thomasfla/pico_dual_PMSM_BUG79100G_DRV8316C/README.md

# pico_dual_PMSM_BUG79100G_DRV8316C
Low cost PMSM using RPI Pico, external ADC and integrated mos+driver+current sensing.
