thomasfla/pico_dual_PMSM_BUG79100G_DRV8316C/hardware/pico_dual_PMSM_BUG79100G_DRV8316C.kicad_pcb

## KiCad design hardware/pico_dual_PMSM_BUG79100G_DRV8316C.kicad_pcb (2026-09-10)

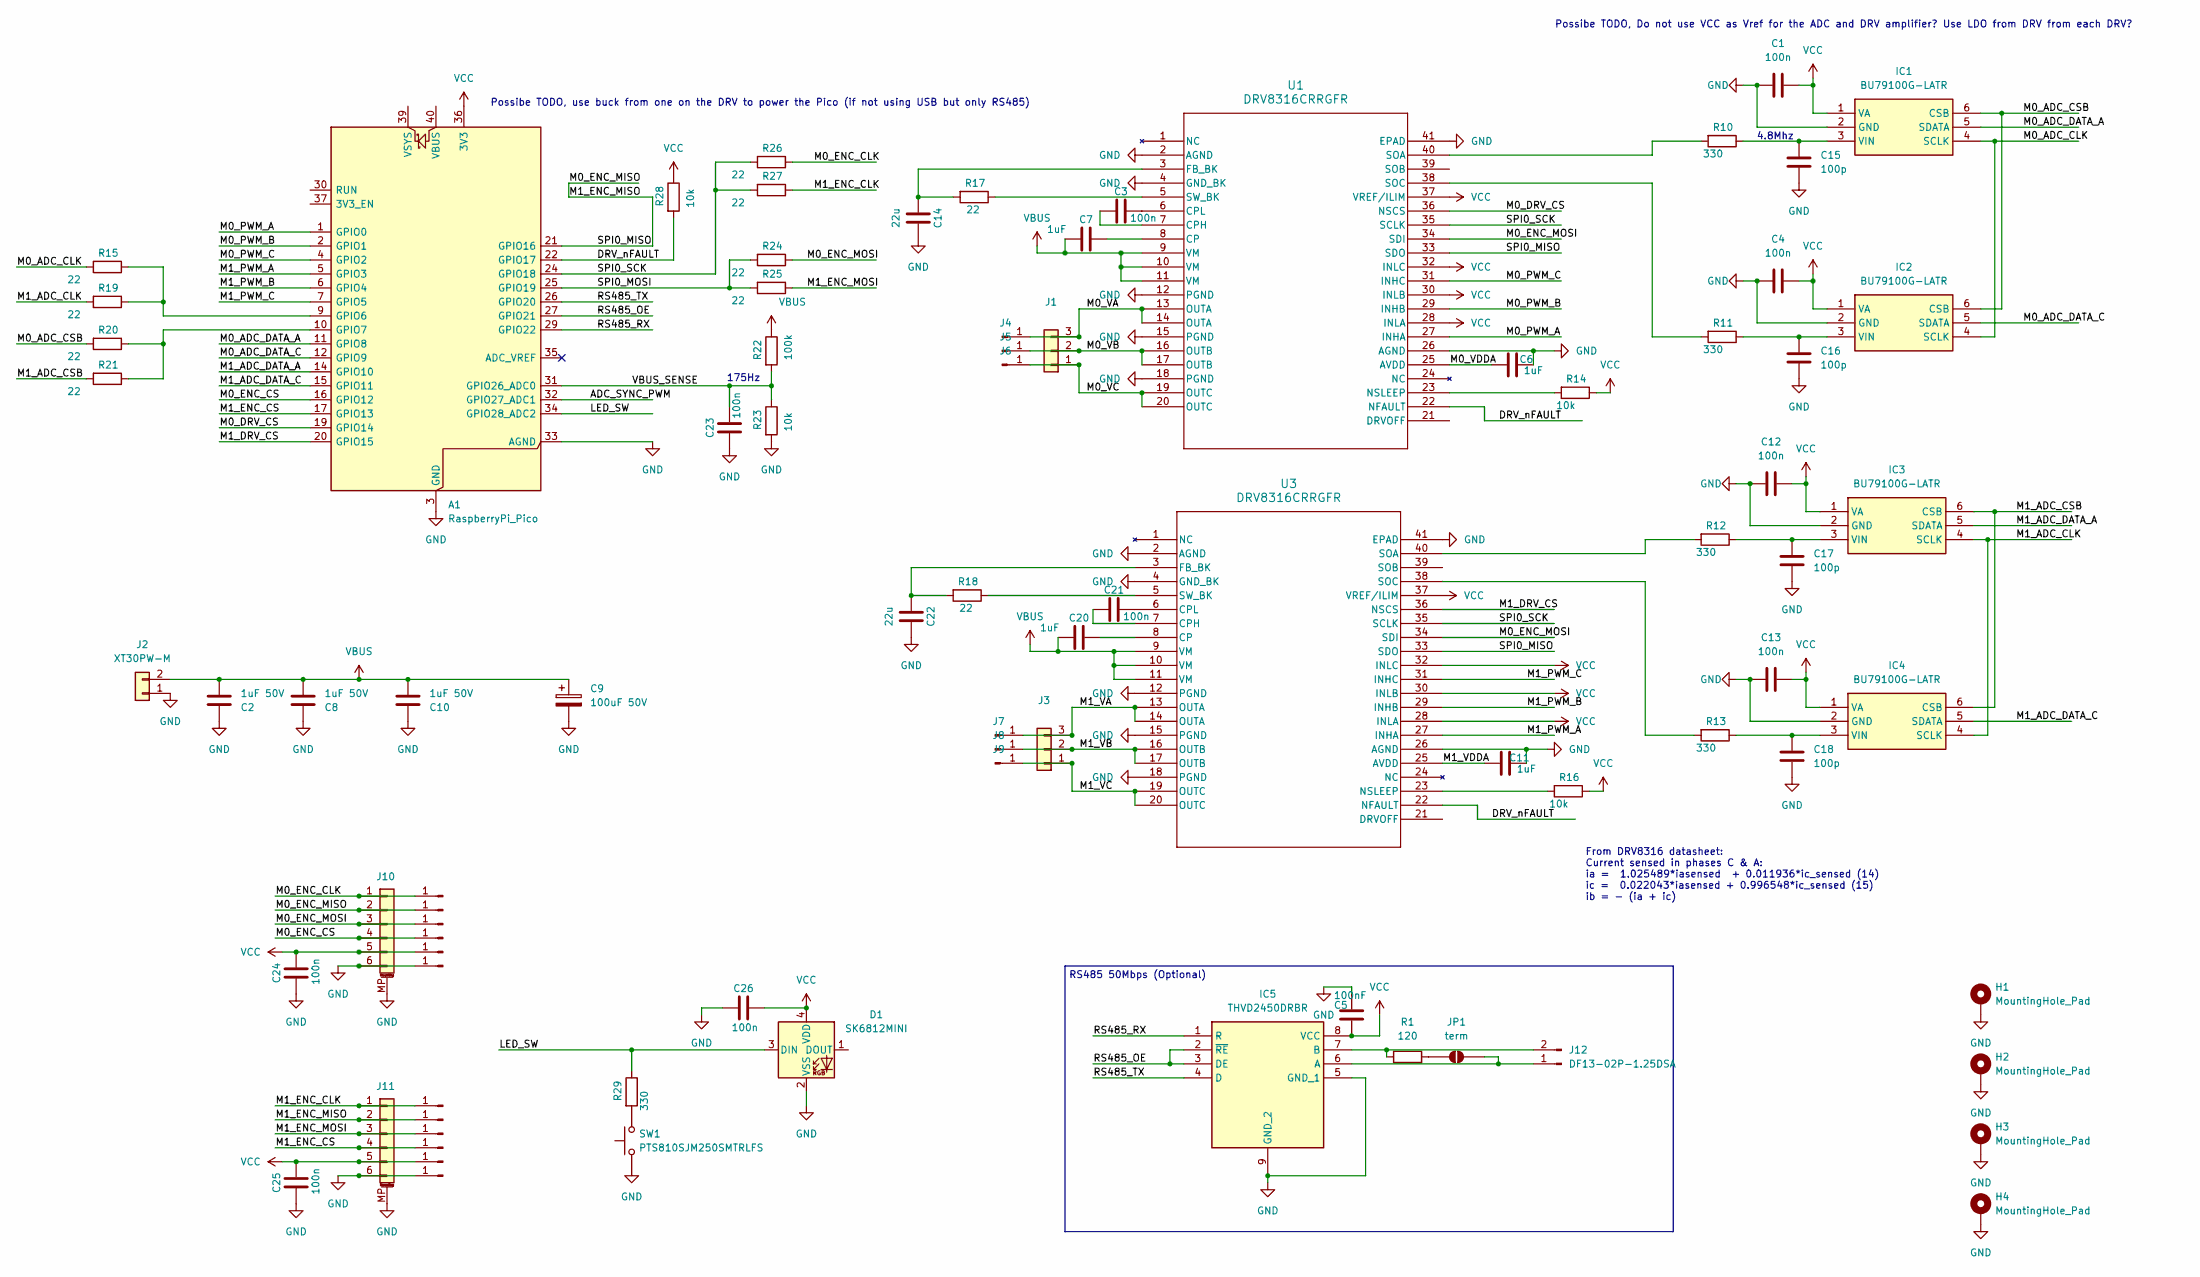
[picture p1: schematic pico_dual_PMSM_BUG79100G_DRV8316C.kicad_sch]

Parts:
A1: RaspberryPi_Pico; RaspberryPi_Pico_Common_Unspecified; Mouser Part Number 358-SC1631; mouser 358-SC1631
C1, C3, C4, C12, C13, C21, C23, C24, C25, C26: 100n; C_0402_1005Metric; Mouser Part Number 187-CL05B104KB5NNWC; mouser 187-CL05B104KB5NNWC
C2, C8, C10: 1uF 50V; C_1206_3216Metric; Mouser Part Number 80-C1206F105M5RAUTO
C5: 100nF; C_0603_1608Metric; Mouser Part Number 81-GRM188R72A104KA35; mouser 81-GRM188R72A104KA35
C6, C7, C11, C20: 1uF; C_0402_1005Metric; Mouser Part Number 187-CL05A105KO5NNNC; mouser 187-CL05A105KO5NNNC
C9: 100uF 50V; CP_Radial_D10.0mm_P5.00mm; Mouser Part Number 594-MAL219051101E3
C14, C22: 22u; C_0805_2012Metric; Mouser Part Number 80-C0805C226M8P; mouser 80-C0805C226M8P
C15, C16, C17, C18: 100p; C_0402_1005Metric; Mouser Part Number 81-GRM1555C1H101JA1J
D1: SK6812MINI; LED_SK6812MINI_PLCC4_3.5x3.5mm_P1.75mm
H1, H2, H3, H4: MountingHole_Pad; MountingHole_2.5mm_Pad_Via
IC1, IC2, IC3, IC4: BU79100G-LATR; SOT95P280X125-6N; MPN BU79100G-LATR; mouser 755-BU79100G-LATR
IC5: THVD2450DRBR; SON65P300X300X100-9N; MPN THVD2450DRBR; mouser 595-THVD2450DRBR
J1, J3: PinHeader_1x03_P2.54mm_Horizontal
J2: XT30PW-M; AMASS_XT30PW-M_1x02_P2.50mm_Horizontal
J4, J5, J6, J7, J8, J9: SolderWirePad_1x01_SMD_2x4mm
J10, J11: BM06B-SRSS-TB; JST_SH_BM06B-SRSS-TB_1x06-1MP_P1.00mm_Vertical; Mouser Part Number 306-6BSRSSTBLPP; mouser 306-6BSRSSTBLPP
J12: DF13-02P-1.25DSA; Hirose_DF13-02P-1.25DSA_1x02_P1.25mm_Vertical
J14, J15, J16, J17, J18, J19, J20, J21, J22, J23, J24, J25: Conn_01x01_Pin; SolderWirePad_1x01_SMD_1x2mm
JP1: term; SolderJumper-2_P1.3mm_Open_RoundedPad1.0x1.5mm
R1: 120; R_0603_1608Metric; Mouser Part Number 603-RC0603FR-07120RL; mouser 603-RC0603FR-07120RL
R10, R11, R12, R13, R29: 330; R_0402_1005Metric; Mouser Part Number 603-RC0402FR-07330RL
R14, R16, R23, R28: 10k; R_0402_1005Metric; Mouser Part Number 603-RC0402FR-0710KL
R15, R17, R18, R19, R20, R21, R24, R25, R26, R27: 22; R_0402_1005Metric; Mouser Part Number 603-RC0402FR-0722RL
R22: 100k; R_0402_1005Metric; Mouser Part Number 603-RC0402FR-07100KL
SW1: PTS810SJM250SMTRLFS; SW_SPST_PTS810; Mouser Part Number 611-PTS810SJM250SMTR; mouser 611-PTS810SJM250SMTR
U1, U3: DRV8316CRRGFR; VQFN40_RGF_TEX; Mouser Part Number 595-DRV8316CRRGFR; mouser 595-DRV8316CRRGFR

Connections:
/ADC_SYNC_PWM: A1.32 (GPIO27_ADC1)
/DRV_nFAULT: A1.22 (GPIO17), R28.2, U1.22 (NFAULT), U3.22 (NFAULT)
/LED_SW: A1.34 (GPIO28_ADC2), D1.3 (DIN), R29.1
/M0_ADC_CLK: IC1.4 (SCLK), IC2.4 (SCLK), R15.2
/M0_ADC_CSB: IC1.6 (CSB), IC2.6 (CSB), R20.2
/M0_ADC_DATA_A: A1.11 (GPIO8), IC1.5 (SDATA)
/M0_ADC_DATA_C: A1.12 (GPIO9), IC2.5 (SDATA)
/M0_DRV_CS: A1.19 (GPIO14), U1.36 (NSCS)
/M0_ENC_CLK: J10.1, J14.1 (Pin_1_1), R26.1
/M0_ENC_CS: A1.16 (GPIO12), J10.4, J17.1 (Pin_1_1)
/M0_ENC_MISO: A1.21 (GPIO16), J10.2, J11.2, J15.1 (Pin_1_1), J21.1 (Pin_1_1), U1.33 (SDO), U3.33 (SDO)
/M0_ENC_MOSI: J10.3, J16.1 (Pin_1_1), R24.1, U1.34 (SDI), U3.34 (SDI)
/M0_PWM_A: A1.1 (GPIO0), U1.27 (INHA)
/M0_PWM_B: A1.2 (GPIO1), U1.29 (INHB)
/M0_PWM_C: A1.4 (GPIO2), U1.31 (INHC)
/M0_VA: J1.3, J4.1 (Pin_1_1), U1.13 (OUTA), U1.14 (OUTA)
/M0_VB: J1.2, J5.1 (Pin_1_1), U1.16 (OUTB), U1.17 (OUTB)
/M0_VC: J1.1, J6.1 (Pin_1_1), U1.19 (OUTC), U1.20 (OUTC)
/M0_VDDA: C6.1, U1.25 (AVDD)
/M1_ADC_CLK: IC3.4 (SCLK), IC4.4 (SCLK), R19.2
/M1_ADC_CSB: IC3.6 (CSB), IC4.6 (CSB), R21.2
/M1_ADC_DATA_A: A1.14 (GPIO10), IC3.5 (SDATA)
/M1_ADC_DATA_C: A1.15 (GPIO11), IC4.5 (SDATA)
/M1_DRV_CS: A1.20 (GPIO15), U3.36 (NSCS)
/M1_ENC_CLK: J11.1, J18.1 (Pin_1_1), R27.1
/M1_ENC_CS: A1.17 (GPIO13), J11.4, J23.1 (Pin_1_1)
/M1_ENC_MOSI: J11.3, J22.1 (Pin_1_1), R25.1
/M1_PWM_A: A1.5 (GPIO3), U3.27 (INHA)
/M1_PWM_B: A1.6 (GPIO4), U3.29 (INHB)
/M1_PWM_C: A1.7 (GPIO5), U3.31 (INHC)
/M1_VA: J3.3, J7.1 (Pin_1_1), U3.13 (OUTA), U3.14 (OUTA)
/M1_VB: J3.2, J8.1 (Pin_1_1), U3.16 (OUTB), U3.17 (OUTB)
/M1_VC: J3.1, J9.1 (Pin_1_1), U3.19 (OUTC), U3.20 (OUTC)
/M1_VDDA: C11.1, U3.25 (AVDD)
/RS485_OE: A1.27 (GPIO21), IC5.2 (~RE), IC5.3 (DE)
/RS485_RX: A1.29 (GPIO22), IC5.1 (R)
/RS485_TX: A1.26 (GPIO20), IC5.4 (D)
/SPI0_MOSI: A1.25 (GPIO19), R24.2, R25.2
/SPI0_SCK: A1.24 (GPIO18), R26.2, R27.2, U1.35 (SCLK), U3.35 (SCLK)
/VBUS_SENSE: A1.31 (GPIO26_ADC0), C23.2, R22.2, R23.1
GND: A1.3 (GND), A1.8 (GND), A1.13 (GND), A1.18 (GND), A1.23 (GND), A1.28 (GND), A1.33 (AGND), A1.38 (GND), C1.1, C2.1, C4.1, C5.1, C6.2, C8.1, C9.2, C10.1, C11.2, C12.1, C13.1, C14.2, C15.2, C16.2, C17.2, C18.2, C22.2, C23.1, C24.1, C25.1, C26.1, D1.2 (VSS), H1.1 (1_1), H2.1 (1_1), H3.1 (1_1), H4.1 (1_1), IC1.2 (GND), IC2.2 (GND), IC3.2 (GND), IC4.2 (GND), IC5.5 (GND_1), IC5.9 (GND_2), J2.1, J10.6, J10.MP (MountPin), J11.6, J11.MP (MountPin), J20.1 (Pin_1_1), J25.1 (Pin_1_1), R23.2, SW1.1, U1.2 (AGND), U1.4 (GND_BK), U1.12 (PGND), U1.15 (PGND), U1.18 (PGND), U1.26 (AGND), U1.41 (EPAD), U3.2 (AGND), U3.4 (GND_BK), U3.12 (PGND), U3.15 (PGND), U3.18 (PGND), U3.26 (AGND), U3.41 (EPAD)
unnamed: A1.9 (GPIO6), R15.1, R19.1
unnamed: A1.10 (GPIO7), R20.1, R21.1
unnamed: C15.1, IC1.3 (VIN), R10.1
unnamed: C16.1, IC2.3 (VIN), R11.1
unnamed: C17.1, IC3.3 (VIN), R12.1
unnamed: C18.1, IC4.3 (VIN), R13.1
unnamed: IC5.6 (A), J12.1, JP1.2 (B)
unnamed: IC5.7 (B), J12.2, R1.1
unnamed: JP1.1 (A), R1.2
unnamed: R29.2, SW1.2
unnamed: C7.2, U1.8 (CP)
unnamed: C3.1, U1.7 (CPH)
unnamed: C3.2, U1.6 (CPL)
unnamed: C14.1, R17.2, U1.3 (FB_BK)
unnamed: R14.2, U1.23 (NSLEEP)
unnamed: R10.2, U1.40 (SOA)
unnamed: R11.2, U1.38 (SOC)
unnamed: R17.1, U1.5 (SW_BK)
unnamed: C20.2, U3.8 (CP)
unnamed: C21.1, U3.7 (CPH)
unnamed: C21.2, U3.6 (CPL)
unnamed: C22.1, R18.2, U3.3 (FB_BK)
unnamed: R16.2, U3.23 (NSLEEP)
unnamed: R12.2, U3.40 (SOA)
unnamed: R13.2, U3.38 (SOC)
unnamed: R18.1, U3.5 (SW_BK)
VBUS: C2.2, C7.1, C8.2, C9.1, C10.2, C20.1, J2.2, R22.1, U1.9 (VM), U1.10 (VM), U1.11 (VM), U3.9 (VM), U3.10 (VM), U3.11 (VM)
VCC: A1.36 (3V3), C1.2, C4.2, C5.2, C12.2, C13.2, C24.2, C25.2, C26.2, D1.4 (VDD), IC1.1 (VA), IC2.1 (VA), IC3.1 (VA), IC4.1 (VA), IC5.8 (VCC), J10.5, J11.5, J19.1 (Pin_1_1), J24.1 (Pin_1_1), R14.1, R16.1, R28.1, U1.28 (INLA), U1.30 (INLB), U1.32 (INLC), U1.37 (VREF/ILIM), U3.28 (INLA), U3.30 (INLB), U3.32 (INLC), U3.37 (VREF/ILIM)

Notes on the sheet:
4.8Mhz
175Hz
RS485 50Mbps (Optional)
Possibe TODO, Do not use VCC as Vref for the ADC and DRV amplifier? Use LDO from DRV from each DRV?
Possibe TODO, use buck from one on the DRV to power the Pico (if not using USB but only RS485)
From DRV8316 datasheet: Current sensed in phases C & A: ia = 1.025489*iasensed + 0.011936*ic_sensed (14) ic = 0.022043*iasensed + 0.996548*ic_sensed (15) ib = − (ia + ic)

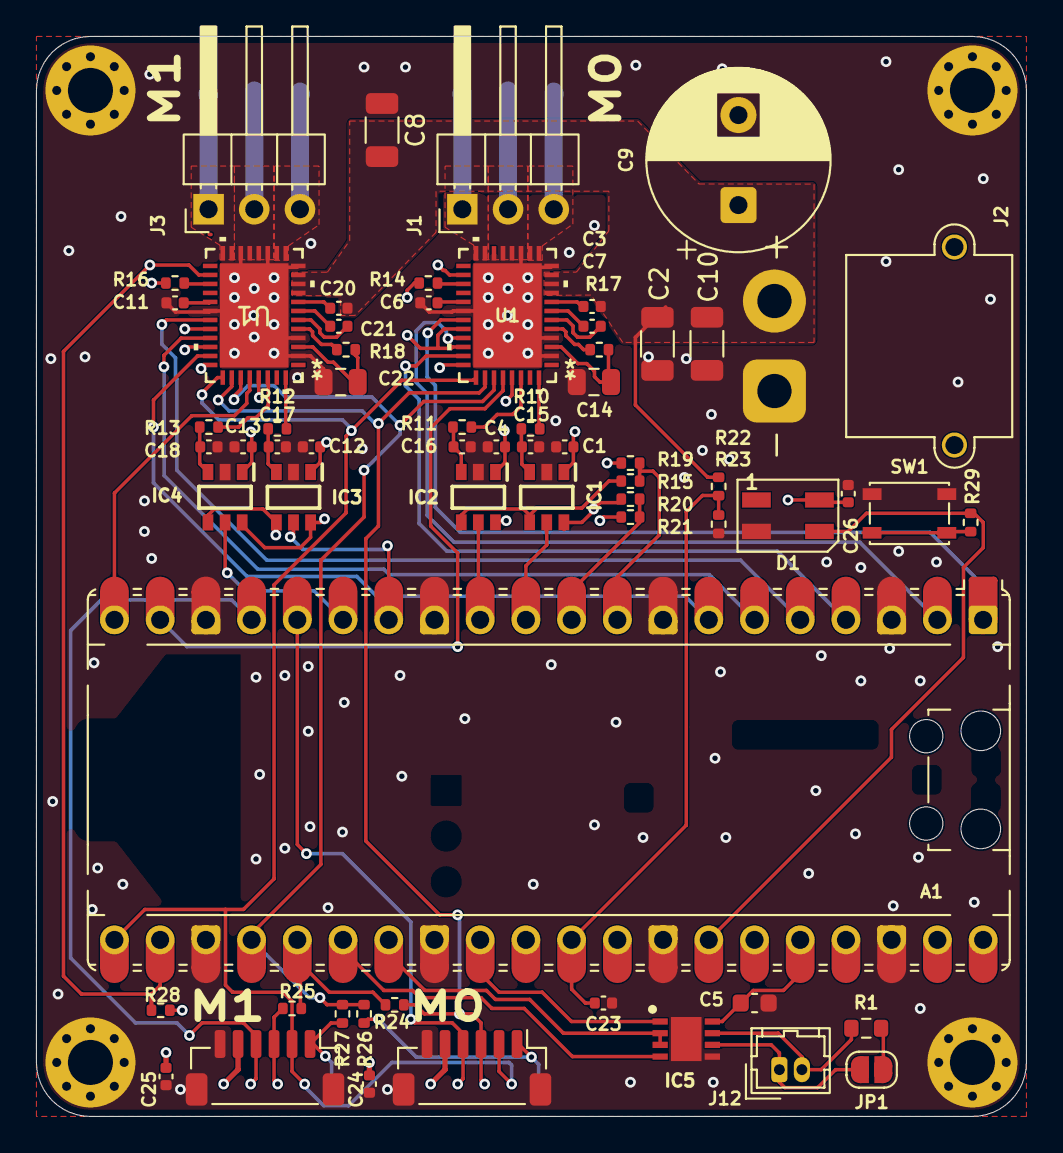
[picture p2: board pico_dual_PMSM_BUG79100G_DRV8316C.kicad_pcb from above]

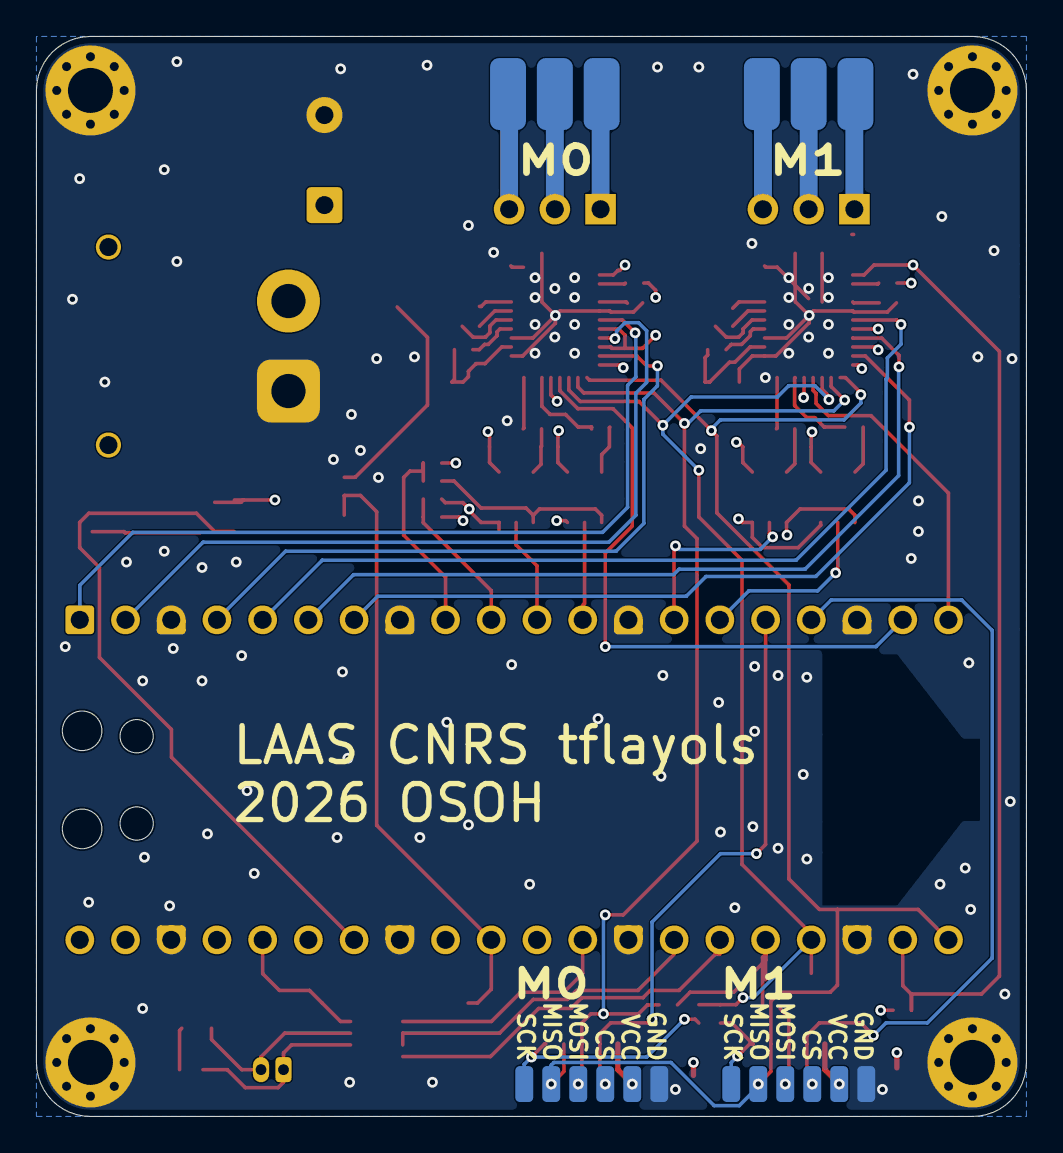
[picture p3: board pico_dual_PMSM_BUG79100G_DRV8316C.kicad_pcb from below]

Board: 4 copper layers, 55.0 x 60.0 mm, 85 parts (18 on the bottom side), 68 nets.
