thomasfla/pico_dual_PMSM_BUG79100G_DRV8316C/firmware/include/BU79100QuadReader.h

#pragma once

#include <Arduino.h>
#include "hardware/pio.h"

struct BU79100QuadSample {
  uint16_t raw[4] = {0, 0, 0, 0};
  uint32_t word0 = 0;
  uint32_t word1 = 0;
  uint32_t sequence = 0;
  bool valid = false;
};

class BU79100QuadReader {
 public:
  BU79100QuadReader(PIO pio, uint8_t pinSck, uint8_t pinCsb, uint8_t pinD0, uint8_t pinTrigger);

  bool init(float sckHz);
  BU79100QuadSample read() const;

 private:
  static constexpr uint32_t RING_WORDS = 64;
  static constexpr uint32_t RING_BYTES = RING_WORDS * sizeof(uint32_t);

  static void dmaInterrupt();
  static BU79100QuadReader *activeReader_;

  PIO pio_;
  uint8_t pinSck_;
  uint8_t pinCsb_;
  uint8_t pinD0_;
  uint8_t pinTrigger_;
  int sm_ = -1;
  int dmaA_ = -1;
  volatile uint32_t completedFrames_ = 0;
  volatile bool receivedBlock_ = false;
  mutable BU79100QuadSample cached_;
  alignas(RING_BYTES) volatile uint32_t buffer_[RING_WORDS] = {};
};
