thomasfla/pico_dual_PMSM_BUG79100G_DRV8316C/(commit log)

2026-06-01 Add fils
    [pico_dual_PMSM_BUG79100G_DRV8316C.kicad_pcb, pico_dual_PMSM_BUG79100G_DRV8316C.kicad_sch]
2026-07-29 update pcb
    [pico_dual_PMSM_BUG79100G_DRV8316C.kicad_pcb, pico_dual_PMSM_BUG79100G_DRV8316C.kicad_sch]
2026-07-29 add first poc of firmware, openloop velocity of two motors with current reading (noisy readings)
2026-08-04 first current based FOC for 2 motor at about 20kHz control loop
2026-08-04 Simplify current FOC control firmware
2026-08-06 Add calibration of encoder offset and electrical angle saved at non-volatile memory
2026-08-07 adapt demo script, print motor state script now uses a table, and add a simple beep script
2026-08-07 Add R L BEMF identification tools. correct a bug in current scaling. adpat the demo gains, tune FOC gains.
    [board_config.h, main.cpp, motor_identification.cpp, motor_identification.h, plot_current.py]
2026-08-07 Improve velocity estimation, send a more filtered version of the velocity via USB for external controller stability, change bin protocol to publish the two versions.
    [board_config.h, main.cpp, motor_usb_client.py, plot_current.py]
2026-08-13 Adapt to variable Vbus, clamp the PWM to let room for current sensing.
2026-08-18 add board diag at boot (press '?' at boot to test)
    [pico_dual_PMSM_BUG79100G_DRV8316C.kicad_pcb, pico_dual_PMSM_BUG79100G_DRV8316C.kicad_sch]
2026-08-25 Add LED status, make custom simpleFOC drivers local
2026-08-26 Tune current sensing and PWM limits
    - center BU79100 real ADC sampling with PIO acquisition guard cycles and trigger duty update
    - clamp active PWM duty to 5-95% while preserving all-zero outputs
    - configure DRV8316 current sense gain for 0.6 V/A and update board-test readback
    - raise position sensor alignment voltage to 3 V
2026-09-02 Define origin for openPnP
    [pico_dual_PMSM_BUG79100G_DRV8316C.kicad_pcb]
2026-09-10 Remove local SimpleFOC dependency and add motor fault protection
    - Pin upstream SimpleFOC and keep board PWM/ADC support in the project
    - Split control, USB, calibration and board-test code into separate modules
    - Fix dual-motor scheduling and validate feedback and PWM deadlines
    - Disable both motors on faults and report the cause over USB
    - Add a polled GPIO 28 E-stop with recovery at 3 seconds on a second press
    - Document the protocol and include host regression checks
    [BU79100QuadReader.cpp, BU79100QuadReader.h, board_config.h, board_pwm.cpp, board_pwm.h, board_test_mode.cpp, calibration_mode.cpp]
2026-09-10 Add mouser part number, height for openpnp, fix silkscreen.
    [pico_dual_PMSM_BUG79100G_DRV8316C.kicad_pcb, pico_dual_PMSM_BUG79100G_DRV8316C.kicad_sch]
2026-09-10 Make default max update 2kHz, Generate error when harware report faults.
    [motor_usb_client.py]
2026-09-10 Reorganize Python scripts around a local motor_usb package
    - Merge demos and tools into software/ with clearer script names
    - Move the USB client and protocol into motor_usb/
    - Remove sys.path workarounds; run directly without installation
    - Remove the legacy firmware timing reader
    - Update documentation and host test imports
    [client.py, protocol.py]
